benahalkar/PCB_ETCHER/README.md

# PCB ETCHER

###### CURRENT VERSION : 1.0.2
###### All updates made to this project are mentioned in the **versionlist.txt** file.

## ABOUT THE PROJECT
* This is a microcontroller-based programmable PCB etcher.
* Etching is a process through which PCBs can be made. 
* Etching a PCB is the most practical way for prototyping or creating simple PCBs yourself.
* You can read more on the process of etching [here](https://www.protoexpress.com/blog/wet-pcb-etching-acidic-alkaline-methods/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,like%20chiseling%20the%20circuit%20board.).
* This project's primary motive is to automate the process of Etching so that minimum human intervention is required while the process is active.

* The controller used in this project is an Arduino Nano.
* This project involves Electronic circuitry and C-programming.
* To make this project, you first need to build the electronic circuitry to utilize the complete set of features.
* After the hardware is created...debug the same using example codes provided in the **/code files/examples** folder. Here, individual codes will test the individual peripherals of the board.
* After all peripherals are tested...upload the main **controller.ino** code provided in the **/code files/controller** folder.

## STEPS TO MAKE THE BOARD
* Schematic Diagrams, Bill Of Materials, Board Routing files are provided in the **/PCB files** folder.
* Create a PCB either via Etching, GPP or by paying a professional to create it for you.\
*NOTE: The routing of the board has been done specifically to accommodate GPP boards...for those who cannot purchase or etch PCBs. The bottom layer (blue) wires can be treated as tracks on the bottom layer, and the top layer (red) wires can be treated as jumpers.*
* Assemble and solder all the components.
* Do a visual inspection of the board, and ensure that no two different tracks are shorted.

## STEPS TO RUN THE SOFTWARE
* Download the zip files provided in the **/code files/libraries** directory and add them to the Arduino library.
* The files mentioned above are the library files required for driving the OLED.
* Start first by testing the board. Upload each example code to verify that the hardware is properly connected and working.
* Open the **controller.ino** file through the Arduino software and upload the code to your Arduino Nano controller.
* The device is now ready!

## HOW TO USE THE DEVICE
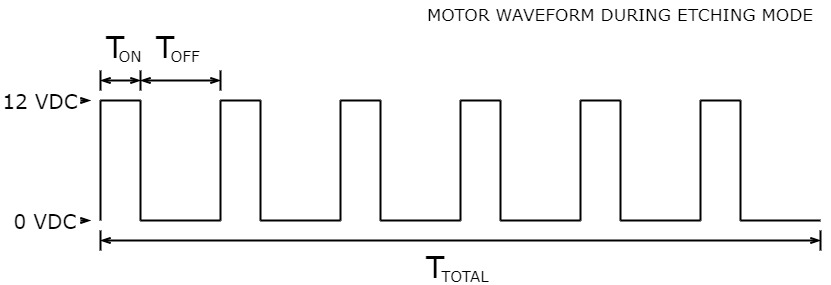
[picture p1: images/PWM.jpg]


* Initially the device starts in SETUP mode.
* Here, you can set the parameters of the etching process with the help of 3 trimmers/potentiometers.
* The first potentiometer sets the time (in seconds) duration for which the motor will remain ON (T On).
* The second potentiometer sets the time (in seconds) duration for which the motor will remain OFF (T Off).
* This turning ON and OFF of the motor is called a cycle.
* The third potentiometer sets the time (in minutes) duration for which the cycles shall occur (T Total).
* All the values that are set during the SETUP mode time are visible on the OLED screen.
* Once you are satisfied with the parameters set, then press the button to initiate the etching process.
* During this time the device is in ETCHING mode.
* During Etching mode, the time left is displayed on the OLED.
* After the etching process is completed, the BUZZER will be activated and shall remain so until the user presses the button again. This has been done to ensure that the etching process is not over-done.

=================================================================

This application has been designed to act as a simple solution to automate the etching process; however, do let me know if you have any suggestions on improving the application.
