benahalkar/PCB_ETCHER/PCB files/SCH_PCB_ETCH.pdf

# GNDled_gpio3

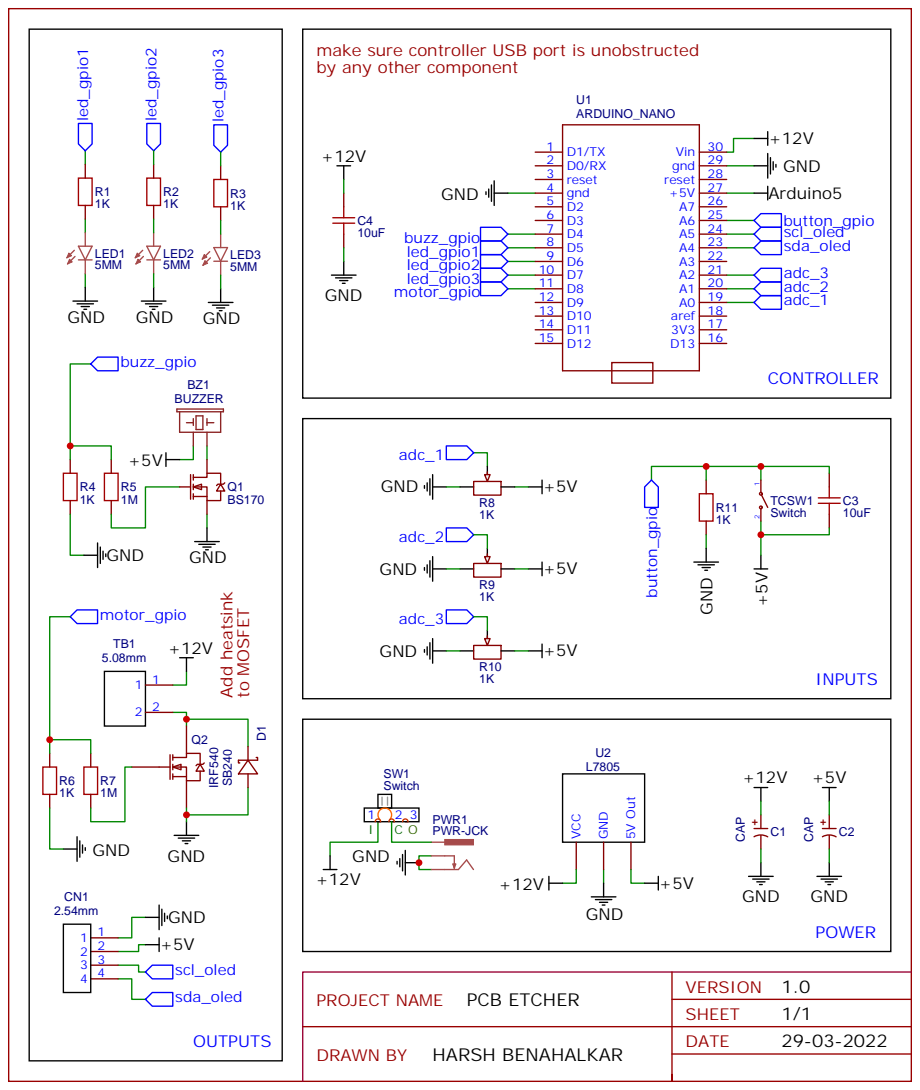
[picture p2: page 1]

make sure controller USB port is unobstructed
by any other component

PROJECT NAME PCB ETCHER
