benahalkar/PCB_ETCHER/PCB files/BRD_PCB_ETCH_02042022.pdf

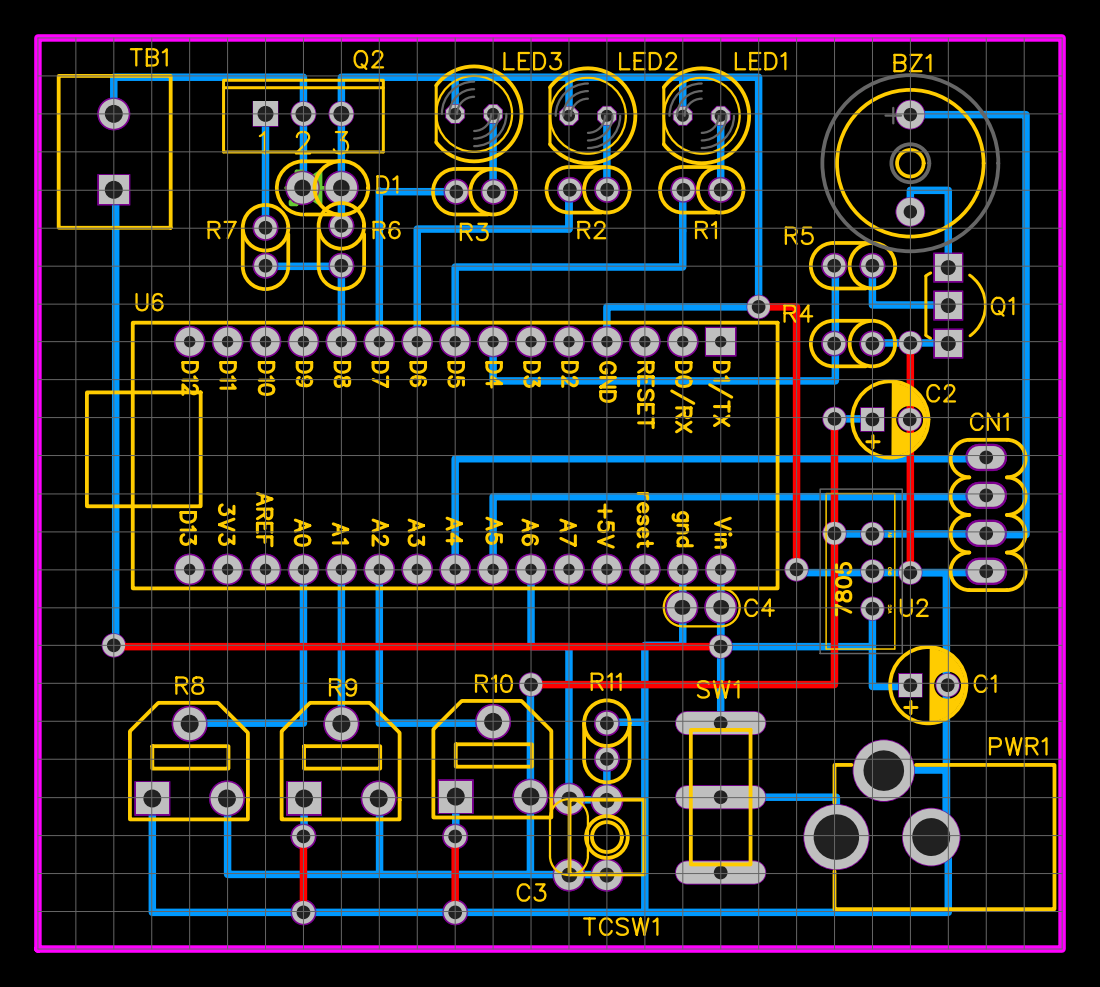
[picture p3: page 1]
