benahalkar/PCB_ETCHER/PCB files/BRD_PCB_ETCH_bottom_layer_02042022.pdf

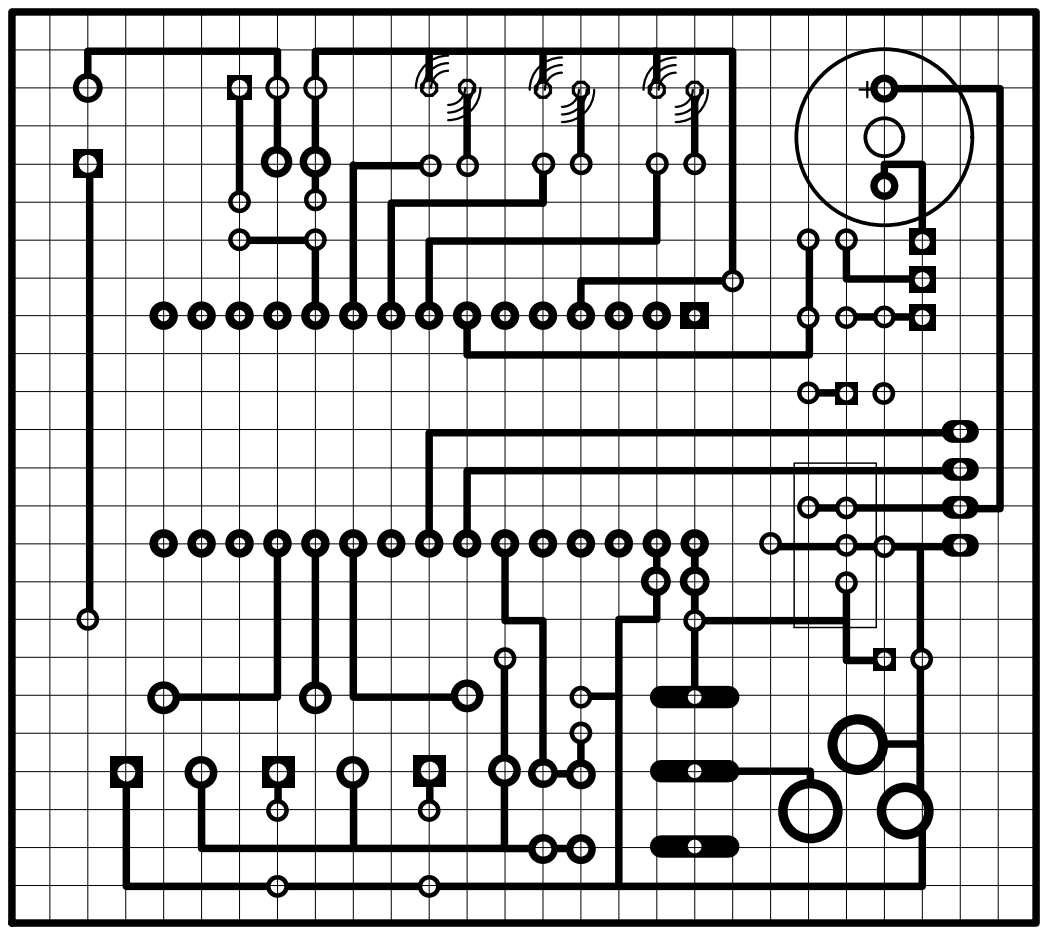
[picture p4: page 1]
