benahalkar/PCB_ETCHER/PCB files/BRD_PCB_ETCH_top_layer_02042022.pdf

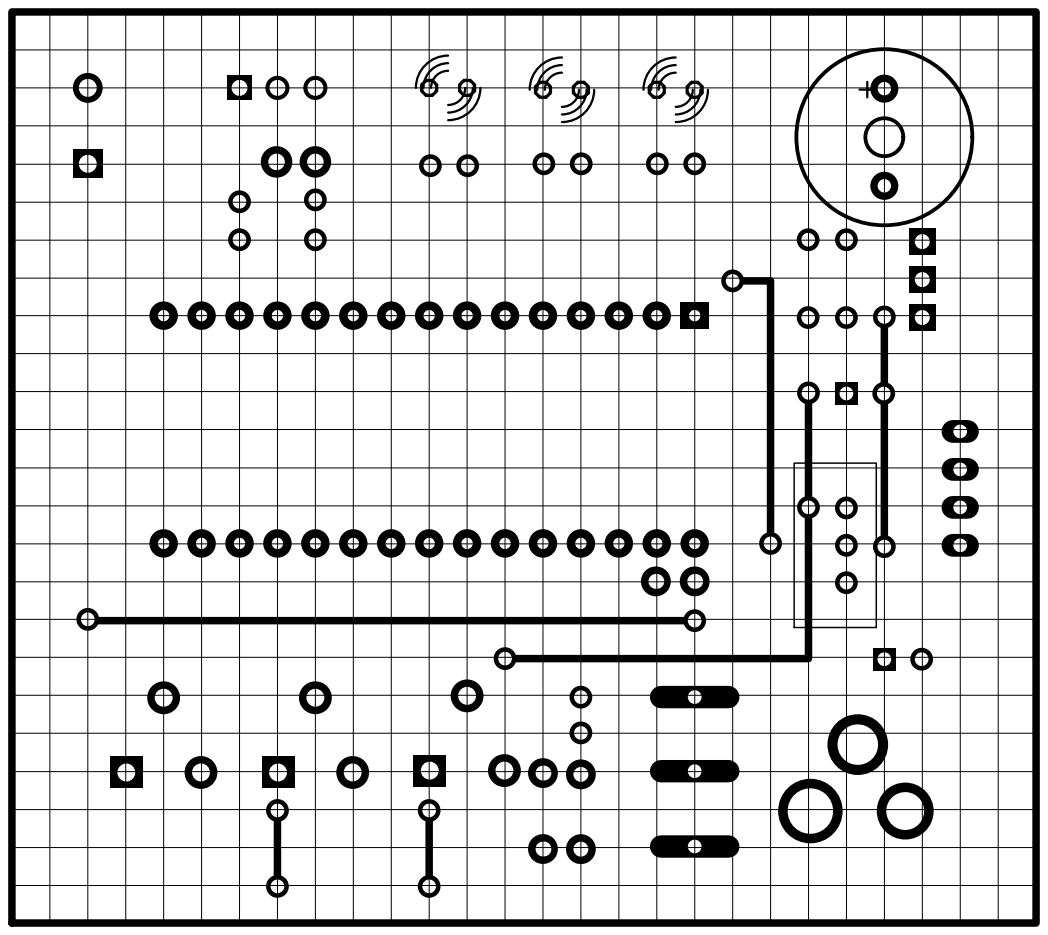
[picture p5: page 1]
