benahalkar/PCB_ETCHER/PCB files/BRD_PCB_ETCH.pdf

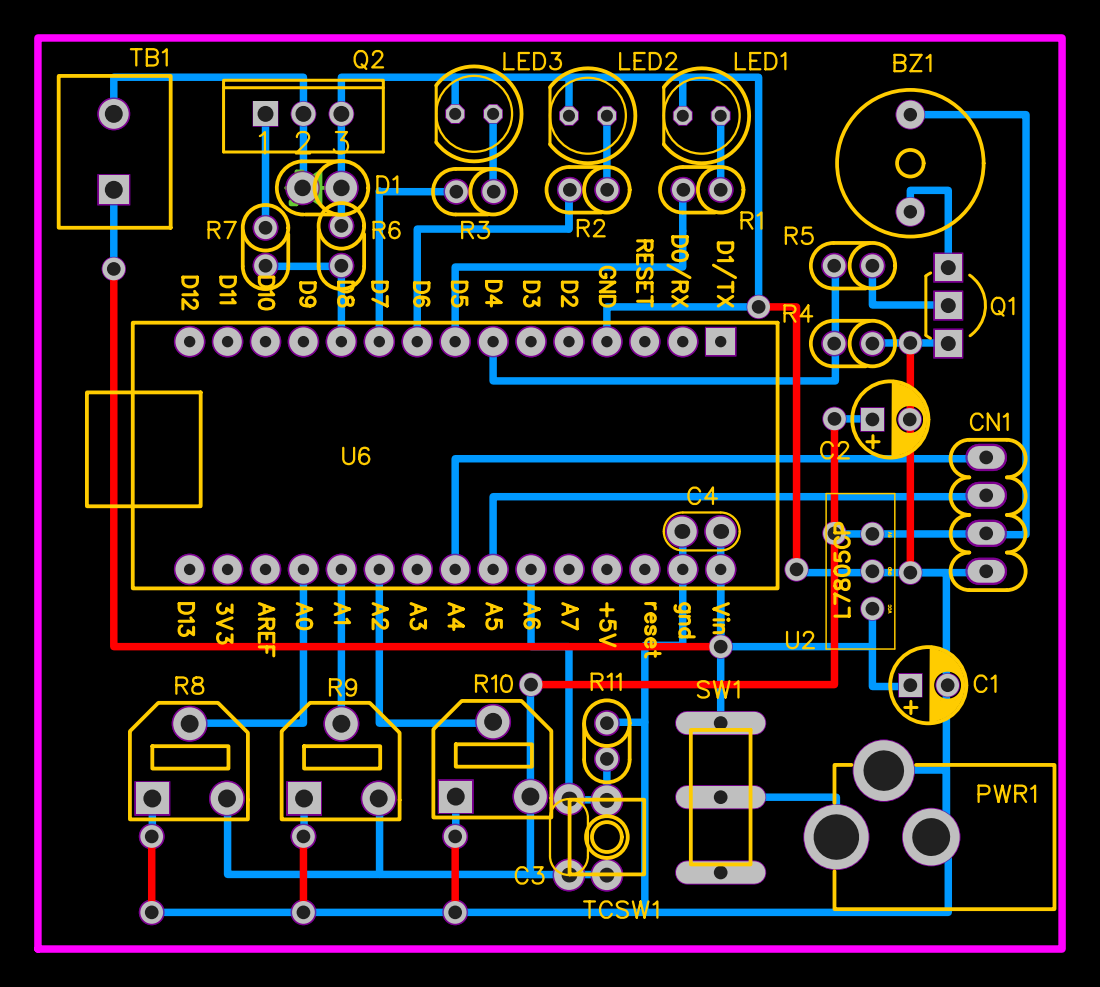
[picture p6: page 1]
