benahalkar/PCB_ETCHER/PCB files/BRD_PCB_ETCH_bottom_layer.pdf

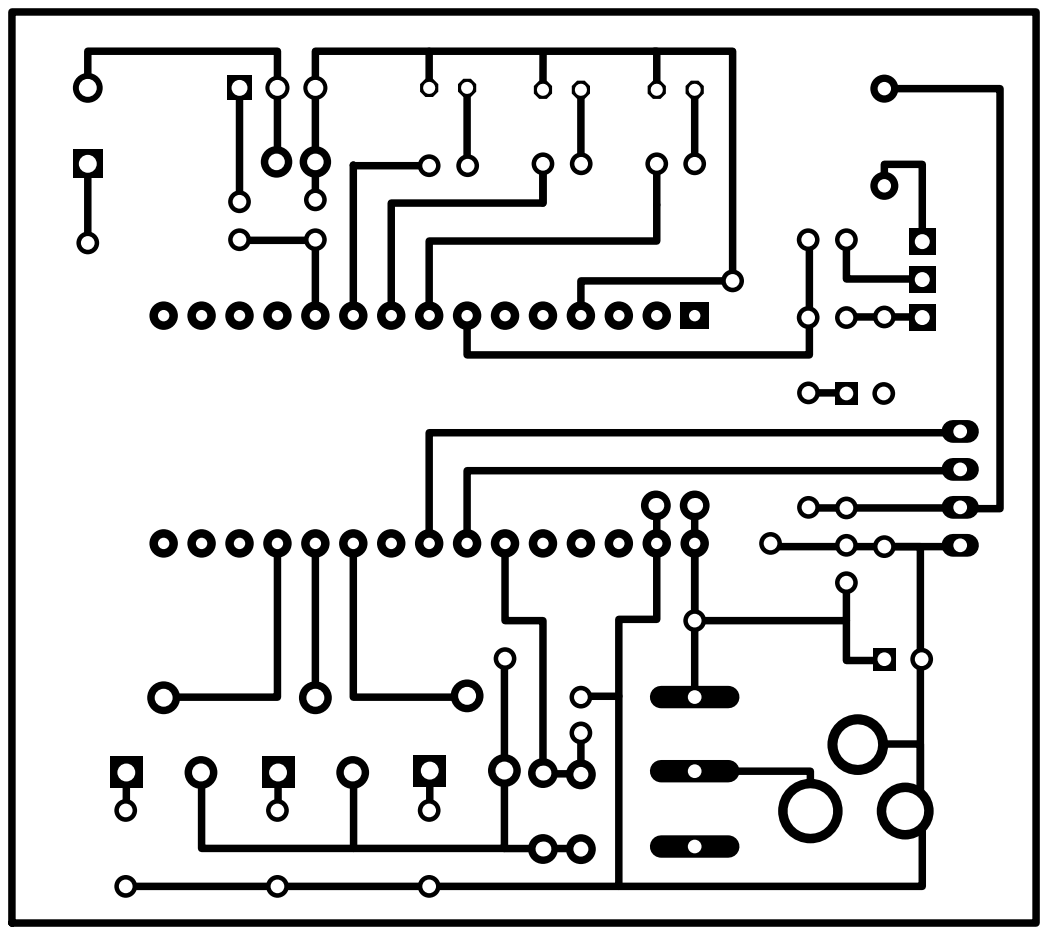
[picture p7: page 1]
