benahalkar/PCB_ETCHER/PCB files/BRD_PCB_ETCH_top_layer.pdf

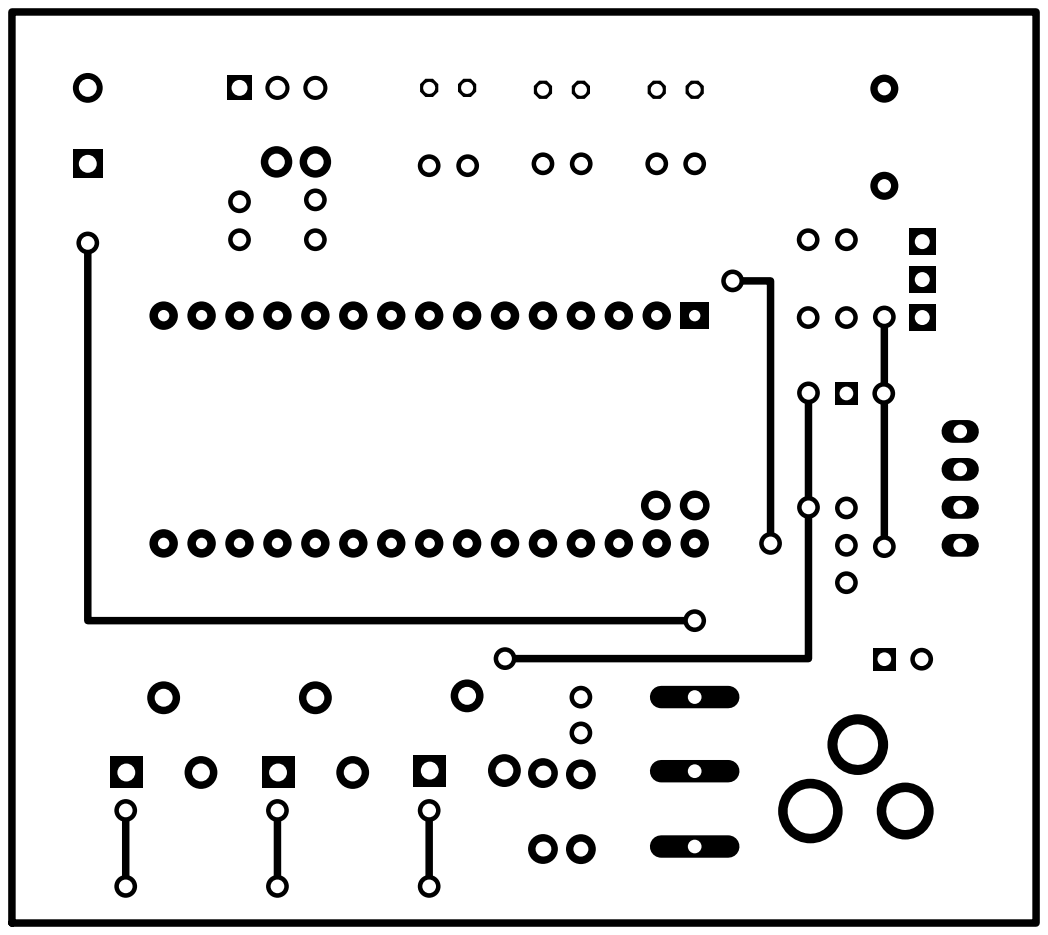
[picture p8: page 1]
