benahalkar/PCB_ETCHER/code files/examples/output_led_test/output_leds_test.ino

int LED1 = 5;
int LED2 = 6;
int LED3 = 7;

void setup() {
  pinMode(LED1, OUTPUT);
  pinMode(LED2, OUTPUT);
  pinMode(LED3, OUTPUT);
}

void loop() {
  digitalWrite(LED1, HIGH);
  digitalWrite(LED2, HIGH);
  digitalWrite(LED3, HIGH);
  delay(1000);
  digitalWrite(LED1, LOW);
  digitalWrite(LED2, LOW);
  digitalWrite(LED3, LOW);
  delay(1000);
}
