benahalkar/PCB_ETCHER/(commit log)

2022-03-29 adding PCB files
2022-04-01 buglist for firmware
    [buglist.xlsx]
2022-04-01 BOM of hardware
2022-04-01 PCB file
2022-04-02 PCB files
